copperdogma/TwoSkulls/data/skits.md

# Skull Skits

The source of truth is the Apple Note called "Skull Skits"

One’s always trying to be scary and the other one undercutting him. 

Badger passersby for candy 

Pretend they’re scary/powerful and threaten people

A: The Demon of Parkhill (Anthony)
B: Jeff (Tobias)

## Names

A: did you know we get to choose new names when we die?
B: do we??
A: yes… I was thinking of something grand, like Blade Lord!
B: hmmm… what about… Janice?
A: Janice?! For whom?
B: for youm!
A: what?! I’m a boy!
B: I don’t think so. 
A: what do you mean you don’t think so?! We’re brothers!
B: mmmm… I think not. We don’t really have any boy parts anymore, do we? And if we can choose new names what about Janice and… Angela. 
A: no! From now on you will address me as The Demon of Parkhill!
B: and you may address me as… Jeffia
A: what?! First of all, you’re also a boy. I know this because we’re BROTHERS. Second, what kind of name is Jeffia?!
B: Well… it’s MY name. 
A: I’m calling you Jeff. 

A 0.0
B 3.09
A 4.04
B 10.52
A 16.64
B 19.13
A 20.45
B 22.36
A 23.83
B 26.60
A 38.92
B 45.32
A 49.90
B 58.39
A 1:02.25

## Skin Cream

A: Boo!
B: Ahhh! You scared my skin off!
A: You haven’t had skin in… 200 years!
B: Well maybe I would if you’d got that skin cream I wanted for Christmas. 

## Milkshakes

B: we should go for milkshakes later 
A: what? Where would we put them?
B: In our hands. 
A: What hands?
B: THESE hands
A: We don’t HAVE hands
B: oh yeah. I forgot. …. Can we still get milkshakes, though?

## Fear Exam

A: Begone! There’s nothing but death ahead!
B: And skulls!
A: Yes! And undead fortune-tellers!
B: And kittens!
A: …vicious MAN EATING kittens!
B: with fluffy ears!
A: …dripping with blood!
B: that meow sweetly. 
A: …you didn’t pass your fear exam, did you?
B: I may have cheated off a fluffy unicorn called Sparklepants

## Spears

A: you there! Drop some of that candy at my feet-
B: what feet?
A: …At the bottom of my spear or I’ll-
B: I think it’s just a stick.
A: whatever! It’s a mighty iron rod of-
B: iron?! Did you get iron?? Mine’s wood and the splinters are terrible 
A: it doesn’t matter! Oh, we’re never getting any candy now. No more out of you! This is why I’m the boss!
B: you? Since when were you the boss?
A: Since we were born!
B: …I don’t remember being born. 
…

## Ju Jubes

A: you there! Give me the… (what are the ones I like called?)
B: (ehrm… ju jubes?)
A: YES! JU JUBES! Give me all of your ju jubes!
B: (and smarties)
A: AND SMARTIES! All of your ju jubes and smarties! Or I’ll.. I’ll… (what will I do?)
B: (throw up on you)
A: THROW UP ON—what?!
B: (I don’t know! It was the first thing that came to mind!)
A: (give me another one) If you don’t give me the ju jubes and smarties I’ll-
B: (kick you)
A: -KICK YOU! Wait, what?! We don’t even have any legs! Or feet! Or anything but skulls!
B: I’m having an off night. It’s probably lack of smarties.

## Plastic Monsters

B: it’s so dark out here
A: it’s night time!
B: since when?!
A: since the sun went down!
B: since when did the sun go down?
A: I don’t know! We only get put out every Halloween.
B: Are you sure it’s Halloween today?
A: pretty sure. If not this neighborhood has a terrible tiny plastic monster infestation. 
B: are you talking about us?!
A: no! That!
B: what?
A: THAT!
B: are you pointing?
A: yes?
B: which direction?
A: that direction!
B: ah! Yes I see them now. They’re hideous!

## Pumpkin Flowers

A: what’s your favourite type of flower?
B: the fat orange glowy ones
A: which?
B: like the one across the street. With the face carved into it. 
A: thats a pumpkin!
B: ah yes. Pumpkin flower!
A: pumpkins aren’t flowers!
B: what did you ask me again?
A: what’s your favourite flower?
B the orange glowy ones
A: pumpkins aren’t flowers!
B: how did you know I was talking about pumpkin flowers?
A: pumpkins. aren’t. flowers!
B: what did you ask me again?
A: forget it
B: forget what?

## Favourite Movie

B: hey Anthony 
A: call me THE DEMON OF PARKHILL
B: okay, so Anthony, what’s your favourite movie?
A: <grumble> Frankenstein. I look forward to the day some mad scientist attaches me to a giant, powerful body that will let me crush my enemies!
B: that sounds lovely.
A: Terribly lovely! … what’s yours?
B: I like My Little Pony.
A: I don’t think I’ve seen that. Do the tiny horses tear people apart?
B: no, the ponies go on adventures with rainbows to cotton candy land!
A: I’m not familiar with those terms. Are they methods of torture?
B: no, rainbows are  bright and cheery and cotton candy is lovely and delicious and pink. 
A: …can we watch it later?

## Imitations

A: COWER BEFORE ME, FOR I AM THE DEMON OF PARKHILL!
B: (imitates Anthony) I am the demon of Parkhill!
A: What?! I sound nothing like that! I sound like this!
B: (imitates Anthony) I sound like this!
A: (Imitates Jeff) I s0uNd liKE tHiS! There, that’s you, that’s what you sound like!
B: (imitates Anthony) I am the great and powerful Demon of Parkhill, and I think I’m sooo awesome!
A: … okay.. that one was pretty good.

## Starbucks

A: (Irrationally mad) Jeff… did I see you drinking something earlier?!
B: 	Why, you sure did Anthony, that was our seasonal pumpkin spice latte! We like to embrace the Halloween spirit!
A: …It did smell pretty goo- Wait, what do you mean “we”?!
B: Our weekly special is iced coffee with cream for only 7.99$ at our location in Mission!
A: Why are you talking like that? It’s extremely confusing and… oddly specific.
B: We also sell really bad cake pops!
A: I thought you said NO to the Starbucks sponsorship.
B: Well, a girl’s gotta make a living!
A: …..wait… YOU’RE A GIRL????!!!!

## AI Analysis/Prompt of Jeff and Anthony

## SKIT FORMAT & STRUCTURE

**Length & Pacing:**
- Skits are short, rapid-fire exchanges (typically 10-15 lines of dialogue)
- Quick back-and-forth banter with minimal setup
- Punchline-oriented structure, often ending on a comedic revelation or frustrated outburst

**Dialogue Style:**
- Conversational and naturalistic, with interruptions and tangents
- Frequent use of parenthetical asides (stage whispers, prompting, reactions)
- Lines often trail off with ellipses (...) for comedic timing
- Questions and misunderstandings drive most exchanges

**Comedy Structure:**
- Setup involves A trying to establish something (authority, scariness, a plan)
- B undermines it through literalism, misunderstanding, or cheerful contradiction
- Escalation through repetition or increasing absurdity
- Often ends with A's exasperation or an unexpected twist

---

## CHARACTER PROFILES

**Skull A - "The Demon of Parkhill" (Anthony)**

*Core Personality:*
- Desperately wants to be taken seriously as scary and powerful
- Theatrical and grandiose in speech patterns ("COWER BEFORE ME!")
- Frustrated older-brother energy; constantly trying to maintain control
- Prone to exasperation when undermined (which is constantly)

*Speech Patterns:*
- Uses dramatic, intimidating language ("Begone!", "mighty iron rod")
- Issues commands and threats
- Frequently corrects or scolds B
- Peppers dialogue with dramatic pauses and emphasis
- Gets increasingly flustered when plans fall apart

*Quirks:*
- Insists on his scary title despite no one using it
- Has specific candy preferences (ju jubes and smarties)
- Simultaneously enjoys scary things (Frankenstein) but is open to cute things (willing to watch My Little Pony)
- Gets irrationally upset about small things
- Claims authority as "the boss" despite no evidence

---

**Skull B - Jeff**

*Core Personality:*
- Relentlessly cheerful and literal-minded
- Seems oblivious to social cues and A's frustration
- Embraces whimsy and cuteness without irony
- Forgetful and easily distracted

*Speech Patterns:*
- Simple, straightforward sentences
- Takes everything literally (physical descriptions, metaphors)
- Often asks clarifying questions that derail conversations
- Casual and conversational; rarely intimidating
- Frequently forgets or misunderstands basic information

*Quirks:*
- Fixates on bodily limitations (no hands, no feet, no skin)
- Enjoys traditionally "cute" things (kittens, ponies, sparkles)
- Gender-ambiguous and doesn't care about it
- Makes terrible suggestions when prompted (threatening to throw up, fluffy unicorns)
- Has sponsored content energy (Starbucks bit)
- "Failed" the fear exam by studying with a unicorn named Sparklepants

---

**DYNAMIC BETWEEN THEM:**

The comedy relies on A playing the "straight man" who wants order and scariness, while B is the chaos agent who cheerfully destroys every attempt through innocence rather than malice. A is perpetually losing control while B seems unaware there's even a power struggle happening. Despite A's frustration, there's an underlying sibling affection—they're stuck together and make it work.
