copperdogma/TwoSkulls/docs/research/2026-11-01-jbl-go2.md

# JBL GO 2 connection experiment — 2026-11-01

Historical first experiment. The [follow-up writing utility](2026-11-01-speaker-config-writing.md)
supersedes the temporary-image state below: SD-selected GO 2 was demonstrated
with clear startup speech and Polo, then Jeff was restored to Flip 6 using the
retained utility. The compile-time override is removed.

## Problem and bounded research

Classic Bluetooth discovery, security pairing and A2DP media negotiation are
separate asynchronous stages. An absent first-result name does not prove an
incompatible speaker. Identify the failed stage before changing radio policy.

- [Espressif Classic GAP API](https://docs.espressif.com/projects/esp-idf/en/v5.4/esp32/api-reference/bluetooth/esp_gap_bt.html):
  discovery includes inquiry and name discovery. Missing EIR names may be
  resolved later by the stack. The linked version is 5.4; inspect the installed
  5.5.4 implementation before assuming a version-specific name-resolution fix.
- [Espressif A2DP API, release 5.5](https://docs.espressif.com/projects/esp-idf/en/release-v5.5/esp32/api-reference/bluetooth/esp_a2dp.html):
  connect to the sink address after source initialization and inspect asynchronous
  connection/media results.
- [JBL GO 2 manual](https://jp.jbl.com/on/demandware.static/-/Sites-masterCatalog_Harman/default/dw5193d0bc/pdfs/JBL_GO2_Instruction-Manual_JAPANESE.pdf):
  Bluetooth button enters pairing mode; legacy PIN is 0000 if requested.
- [JBL GO 2 specifications](https://www.jbl.com/on/demandware.static/-/Sites-masterCatalog_Harman/default/dw26d91c33/pdfs/JBL_GO2_Spec_Sheet_English.pdf):
  A2DP sink support makes a Classic ESP32 source a plausible compatible source.
  Specifications alone do not demonstrate this unit working.

Decision: first select the requested speaker, retain exact-name selection and
existing PIN/SSP behavior, then observe discovery, authentication, negotiated
codec and PCM. Do not add retries or codec workarounds without evidence.

Installed 5.5.4 `esp_gap_bt_api.h` lines 636–640 explicitly confirms discovery
produces `ESP_BT_GAP_DISC_RES_EVT` for both inquiry and subsequent name discovery.
Current code consumes those results and waits for discovery stop; no extra
remote-name operation is justified before a local discovery failure is observed.

## Experiment setup

Active source is `codex/jaw-articulation` at 757d5ac, not historical Arduino main.
Connected board verified as Jeff, base MAC f4:2d:c9:78:ad:78. Initial serial
shows ESP-IDF 5.5.4, ELF prefix 6cd2543e7, role secondary, SD mounted and configured
speaker JBL Flip 6, volume 60%. Status/fault-log collected before changes; no
pending report. Opening serial incidentally reset the USB board despite reset
being disabled in the helper, as already documented for this USB driver.

The saved rollback application was verified against actual flash at 0x30000
(esptool digest matched). Private evidence/rollback ELF and BIN:
`build/validation/jbl-go2-20261101/`; initial capture:
`build/validation/2026-11-01-jbl-go2-initial.log`.

Test build option `SKULL_JBL_GO2_EXPERIMENT=ON` overrides only secondary radio
selection to `JBL GO 2`. Default OFF retains SD selection. It does not rewrite SD
config or erase bonds/NVS. Reflash the verified rollback image to restore normal
selection. Ordinary successful pairing may write Bluetooth bonds and the
name-bound speaker cache; preserve unrelated NVS namespaces.

Cam confirmed GO 2 discoverable on the phone after forgetting its old pairing.
Connection and acoustic results follow below; power-cycle recovery remains open.

Build with the experimental option passed. Application-only write at 0x30000
completed with esptool hash verification; running ELF prefix a96f48a40. Rollback
BIN SHA256 b2aaa5163be6811b437e270bdb70afc5e03a5b0d125a770ff9b538201e65d013;
experiment BIN SHA256 b6cd4c07ae0a1dd22eeff6b4225c136fbd57678de15d59478680a13f95ccc36e.
`live.log` confirms the override, healthy mounted card and inquiry start/stop,
but the first completed inquiry received no candidates. Requested the physical
Bluetooth button again because discovery may have expired during the build;
this is not yet evidence of an authentication or A2DP failure.

## Live result

After Cam renewed pairing mode, inquiry saw an unnamed result and then the exact
`JBL GO 2` name at the same address (2c:fd:b4:eb:84:a7). This locally demonstrates
the existing two-stage name discovery works; no name-resolution workaround needed.
At uptime 128.050 s the exact candidate was selected; authentication status 0
at 130.800 s, A2DP connected at 130.870 s, media start success at 130.950 s.
SBC raw 21:15:02:35, 44.1 kHz stereo, bitpool 2..53. Startup PCM completed at
134.900 s. Status at 136.290 s: speaker=1, stream=1, dropped=0, fault=0.

No radio/security/codec change was required for this first successful software
connection. The physical pairing window and selecting GO 2 rather than Flip 6
were sufficient in this experiment. The historical Arduino failure was not
reproduced or diagnosed. Acoustic confirmation and power-cycle recovery remain
separate from the successful connection/PCM-delivery telemetry.

At the end of the first experiment Jeff ran the explicit test image selecting
GO 2; SD config still selected Flip 6. No Anthony or Death image was changed.
Changes were local/uncommitted at that stage. Saved artifacts make the original
experiment and return to the verified previous application reviewable.

## Acoustic confirmation

Cam reported no audible initial startup announcement despite completed source
PCM. Keep that negative observation: cold-start speech readiness is unresolved.
Do not call the initial startup acoustically successful or assume a cause.

Explicit serial `tone` was accepted at 156.010 s and Cam heard it. Next,
`play /audio/Polo.wav` was accepted at 165.310 s, played at 165.440 s and
completed at 166.000 s: 24,289 frames, zero underruns. Cam reported “I heard
Polo” and confirmed clear speech through GO 2. Status after playback:
speaker=1, stream=1, dropped=0, fault=0, SD mounted, actuator stuck=0.
This establishes an audible live connection and SD speech playback; sustained
show playback, power-cycle reconnection and first-announcement timing remain
unqualified. Leave the selected experimental image running for Cam's experiment.
