copperdogma/TwoSkulls/hardware/perfboard/draft-v4/perfboarder-draft.png

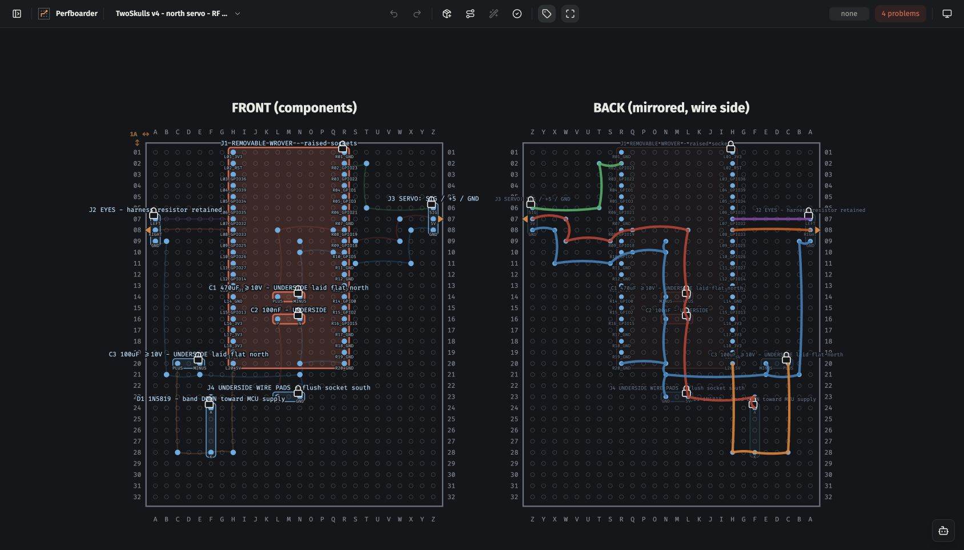
hardware/perfboard/draft-v4/perfboarder-draft.png
