copperdogma/TwoSkulls/hardware/perfboard/tool-trial/perfboarder-trial.png

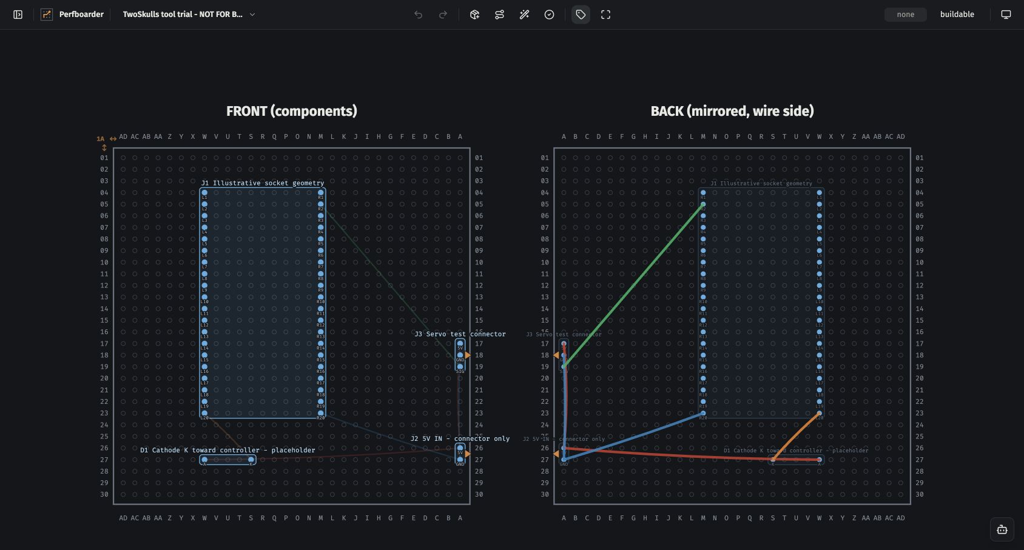
hardware/perfboard/tool-trial/perfboarder-trial.png
