copperdogma/TwoSkulls/hardware/perfboard/draft-v4/wiring.csv

net | from | from_col_row | to | to_col_row
EXT_5V | @12,8 | (12, 8) | C1.PLUS | (12, 14)
EXT_5V | C1.PLUS | (12, 14) | C2.P | (12, 16)
EXT_5V | C2.P | (12, 16) | J4.5V | (12, 23)
EXT_5V | @12,8 | (12, 8) | @17,8 | (17, 8)
EXT_5V | @17,8 | (17, 8) | @19,9 | (19, 9)
EXT_5V | @19,9 | (19, 9) | @23,9 | (23, 9)
EXT_5V | @23,9 | (23, 9) | @23,7 | (23, 7)
EXT_5V | @23,7 | (23, 7) | J3.5V | (26, 7)
EXT_5V | J4.5V | (12, 23) | @6,23 | (6, 23)
EXT_5V | @6,23 | (6, 23) | D1.A | (6, 24)
GND | @14,9 | (14, 9) | @14,10 | (14, 10)
GND | @14,10 | (14, 10) | C1.MINUS | (14, 14)
GND | C1.MINUS | (14, 14) | C2.N | (14, 16)
GND | C2.N | (14, 16) | @14,20 | (14, 20)
GND | @14,20 | (14, 20) | @14,21 | (14, 21)
GND | @14,21 | (14, 21) | J4.GND | (14, 23)
GND | @14,10 | (14, 10) | @17,10 | (17, 10)
GND | @17,10 | (17, 10) | @19,11 | (19, 11)
GND | @19,11 | (19, 11) | @24,11 | (24, 11)
GND | @24,11 | (24, 11) | @24,8 | (24, 8)
GND | @24,8 | (24, 8) | J3.GND | (26, 8)
GND | @14,20 | (14, 20) | J1.R20_GND | (18, 20)
GND | @14,21 | (14, 21) | @5,21 | (5, 21)
GND | @5,21 | (5, 21) | @2,21 | (2, 21)
GND | @2,21 | (2, 21) | @2,9 | (2, 9)
GND | @2,9 | (2, 9) | J2.GND | (1, 9)
GND | @5,21 | (5, 21) | C3.MINUS | (5, 20)
MCU_5V | D1.K | (6, 28) | @8,28 | (8, 28)
MCU_5V | @8,28 | (8, 28) | J1.L20_5V | (8, 20)
MCU_5V | D1.K | (6, 28) | @3,28 | (3, 28)
MCU_5V | @3,28 | (3, 28) | C3.PLUS | (3, 20)
EYE_LEFT | J1.L07_GPIO32 | (8, 7) | J2.LEFT | (1, 7)
EYE_RIGHT | J1.L08_GPIO33 | (8, 8) | J2.RIGHT | (1, 8)
SERVO_PWM | J1.R02_GPIO23 | (18, 2) | @20,2 | (20, 2)
SERVO_PWM | @20,2 | (20, 2) | @20,6 | (20, 6)
SERVO_PWM | @20,6 | (20, 6) | J3.SIG | (26, 6)
