copperdogma/TwoSkulls/hardware/perfboard/draft-v1/wiring.csv

net | endpoint_a | hole_a_col_row | endpoint_b | hole_b_col_row
EXT_5V | J4.5V | (20, 23) | @20,20 | (20, 20)
EXT_5V | @20,20 | (20, 20) | @21,20 | (21, 20)
EXT_5V | @21,20 | (21, 20) | @21,19 | (21, 19)
EXT_5V | @21,19 | (21, 19) | @21,13 | (21, 13)
EXT_5V | @21,13 | (21, 13) | @21,9 | (21, 9)
EXT_5V | @21,9 | (21, 9) | C2.P | (23, 9)
EXT_5V | @21,13 | (21, 13) | J3.5V | (26, 13)
EXT_5V | @21,19 | (21, 19) | C1.PLUS | (23, 19)
EXT_5V | J4.5V | (20, 23) | @18,23 | (18, 23)
EXT_5V | @18,23 | (18, 23) | @18,26 | (18, 26)
EXT_5V | @18,26 | (18, 26) | @5,26 | (5, 26)
EXT_5V | @5,26 | (5, 26) | D1.A | (5, 25)
MCU_5V | D1.K | (5, 21) | @2,21 | (2, 21)
MCU_5V | @2,21 | (2, 21) | C3.PLUS | (2, 28)
MCU_5V | D1.K | (5, 21) | @8,21 | (8, 21)
MCU_5V | @8,21 | (8, 21) | J1.L20_5V | (8, 20)
GND | J4.GND | (20, 24) | @21,24 | (21, 24)
GND | @21,24 | (21, 24) | @21,21 | (21, 21)
GND | @21,21 | (21, 21) | @25,21 | (25, 21)
GND | @25,21 | (25, 21) | C1.MINUS | (25, 19)
GND | C1.MINUS | (25, 19) | @25,14 | (25, 14)
GND | @25,14 | (25, 14) | C2.N | (25, 9)
GND | @25,14 | (25, 14) | J3.GND | (26, 14)
GND | @19,24 | (19, 24) | @19,29 | (19, 29)
GND | @19,29 | (19, 29) | @4,29 | (4, 29)
GND | @4,29 | (4, 29) | C3.MINUS | (4, 28)
GND | J4.GND | (20, 24) | @19,24 | (19, 24)
GND | @19,24 | (19, 24) | @19,21 | (19, 21)
GND | @19,21 | (19, 21) | @19,20 | (19, 20)
GND | @19,20 | (19, 20) | J1.R20_GND | (18, 20)
GND | @4,29 | (4, 29) | @4,10 | (4, 10)
GND | @4,10 | (4, 10) | @1,10 | (1, 10)
GND | @1,10 | (1, 10) | J2.GND | (1, 9)
EYE_LEFT | J1.L07_GPIO32 | (8, 7) | J2.LEFT | (1, 7)
EYE_RIGHT | J1.L08_GPIO33 | (8, 8) | J2.RIGHT | (1, 8)
SERVO_PWM | J1.R02_GPIO23 | (18, 2) | @20,2 | (20, 2)
SERVO_PWM | @20,2 | (20, 2) | @20,12 | (20, 12)
SERVO_PWM | @20,12 | (20, 12) | J3.SIG | (26, 12)
