copperdogma/TwoSkulls/hardware/perfboard/draft-v2/wiring.csv

net | from | from_col_row | to | to_col_row
EXT_5V | @9,6 | (9, 6) | @9,22 | (9, 22)
EXT_5V | @9,22 | (9, 22) | @9,24 | (9, 24)
EXT_5V | @9,24 | (9, 24) | C2.P | (9, 25)
EXT_5V | C2.P | (9, 25) | C1.PLUS | (9, 28)
EXT_5V | @9,22 | (9, 22) | D1.A | (6, 22)
EXT_5V | @9,24 | (9, 24) | @18,24 | (18, 24)
EXT_5V | @18,24 | (18, 24) | J3.5V | (26, 24)
EXT_5V | @18,24 | (18, 24) | @18,28 | (18, 28)
EXT_5V | @18,28 | (18, 28) | J4.5V | (20, 28)
GND | @11,6 | (11, 6) | @11,20 | (11, 20)
GND | @11,20 | (11, 20) | @11,21 | (11, 21)
GND | @11,21 | (11, 21) | C2.N | (11, 25)
GND | C2.N | (11, 25) | C1.MINUS | (11, 28)
GND | C1.MINUS | (11, 28) | @11,30 | (11, 30)
GND | @11,20 | (11, 20) | J1.R20_GND | (18, 20)
GND | @11,21 | (11, 21) | @4,21 | (4, 21)
GND | @4,21 | (4, 21) | @3,21 | (3, 21)
GND | @3,21 | (3, 21) | @3,9 | (3, 9)
GND | @3,9 | (3, 9) | J2.GND | (1, 9)
GND | C2.N | (11, 25) | J3.GND | (26, 25)
GND | @4,21 | (4, 21) | C3.MINUS | (4, 23)
GND | @11,30 | (11, 30) | @20,30 | (20, 30)
GND | @20,30 | (20, 30) | J4.GND | (20, 29)
MCU_5V | D1.K | (6, 26) | @8,26 | (8, 26)
MCU_5V | @8,26 | (8, 26) | J1.L20_5V | (8, 20)
MCU_5V | D1.K | (6, 26) | @2,26 | (2, 26)
MCU_5V | @2,26 | (2, 26) | C3.PLUS | (2, 23)
EYE_LEFT | J1.L07_GPIO32 | (8, 7) | J2.LEFT | (1, 7)
EYE_RIGHT | J1.L08_GPIO33 | (8, 8) | J2.RIGHT | (1, 8)
SERVO_PWM | J1.R02_GPIO23 | (18, 2) | @20,2 | (20, 2)
SERVO_PWM | @20,2 | (20, 2) | @20,23 | (20, 23)
SERVO_PWM | @20,23 | (20, 23) | J3.SIG | (26, 23)
