copperdogma/TwoSkulls/hardware/perfboard/draft-v4/assembly-plan.png

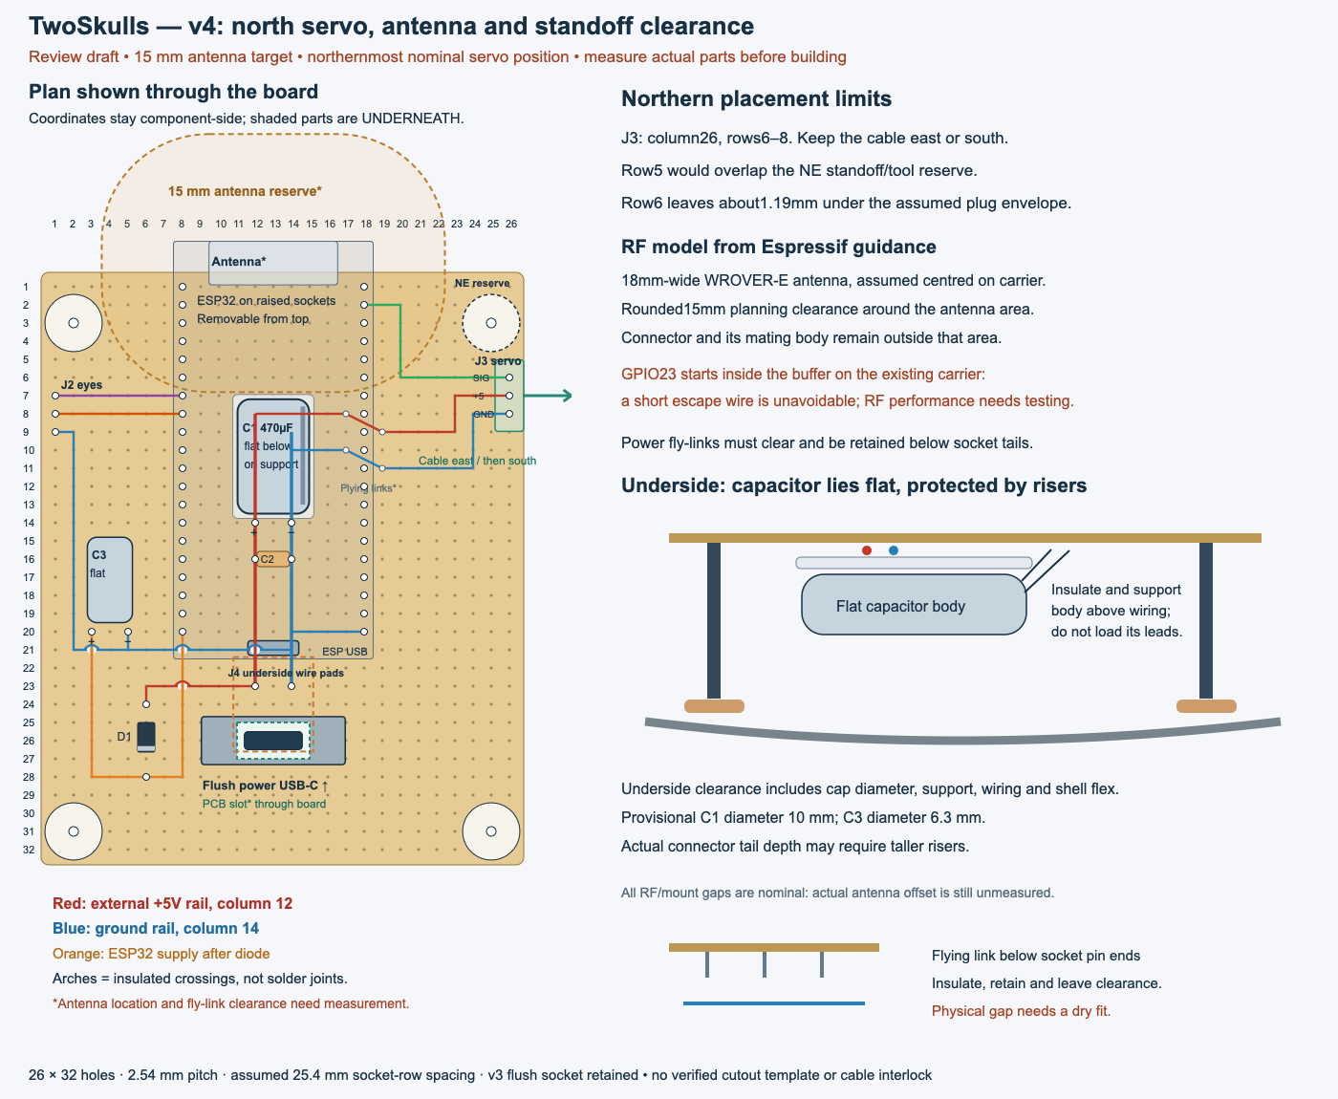
hardware/perfboard/draft-v4/assembly-plan.png
