copperdogma/TwoSkulls/docs/validation/2026-10-15-checkin.md

# Shared WROVER firmware check-in — 2026-10-15

Scope: onboard-SD migration baseline, native ESP-IDF dual-role application,
research/implementation evidence, host tests and a repeatable host-test runner.
All work is isolated on `codex/onboard-sd-migration`; the original checkout stays
unchanged. Next work is the physical board design, rather than another software
architecture migration.

## Validation

- `python3 scripts/run_host_tests.py`: passed. Eight Python tests and eight C++
  production-source suites under Address/UndefinedBehaviorSanitizer, including
  all15 real WAV fixtures, catalog/config/storage, primary/secondary control,
  actual PCM producer, actuator timing and28 deterministic show scenarios.
- ESP-IDF5.5.4 native build: passed. Rebuilt image SHA256 matches the exact image
  hash-verified on both connected boards:
  `cf4692a71f1f29405cf85f77b9c03606e826ea2730444cd1c633aec85cc88a25`.
- Strict offline asset preflight: one existing authored-data failure remains,
  `Skit - names.wav: line 15: interval extends beyond PCM data`. Verified no other
  errors. Runtime clips the final interval at EOF and accepts all15assets;
  authored repository/card content remains untouched. This is not an all-assets
  authoring-clean claim.
- Hardware: both boards completed Starbucks1647341frames and Home-triggered
  imitations1341581frames with zero reported underruns. Cam confirmed clean
  alternating dialogue and Home switch reset to off. Startup margin correction
  and Jeff's initialization/Polo were owner-confirmed. See
  [the two-board record](2026-10-15-jeff-first-boot.md).
- Independent source/concurrency and commit-candidate review: no blocking finding.
  No firmware binaries, device backups, generated SDK/build files, private serial
  captures or commissioning credentials are included. Dependency lockfile is
  intentionally tracked. `git diff --check` passed.

## Remaining physical/resource acceptance

Jeff's disconnected jaw/eyes, precise acoustic offset, fault-injection/recovery,
full-load memory margin and yard/long-soak checks remain open. Static IRAM margin
is993bytes; primary local-window low31191bytes is below the proposed32KiB floor.
Do not turn these bounded bench results into a full hardware/soak qualification.
The original images remain private outside Git. Ordinary future app updates
must preserve each board's native NVS and SD contents.

Ignored validation outputs use the `2026-10-15-checkin-*` prefix. The checked-in
runner uses isolated temporary fixtures and does not access connected hardware.
