copperdogma/TwoSkulls/firmware/main/app_main.cpp

#include <algorithm>
#include <atomic>
#include <cstdio>
#include <cstring>
#include <new>
#include "freertos/FreeRTOS.h"
#include "freertos/task.h"
#include "driver/uart.h"
#include "esp_heap_caps.h"
#include "esp_log.h"
#include "esp_psram.h"
#include "esp_system.h"
#include "esp_timer.h"
#include "esp_wifi.h"
#include "nvs_flash.h"
#include <esp_matter.h>
#include <app/server/Server.h>
#include <platform/CHIPDeviceLayer.h>
#include <setup_payload/OnboardingCodesUtil.h>
#include "skull_radio.h"
#include "skull_storage.h"
#include "skull_startup.h"
#include "skull_actuators.h"
#include "skull_audio.h"
#include "skull_catalog.h"
#include "skull_show.h"
#include "skull_fault_log.h"
#include "skull_secondary.h"
#include "skull_network.h"

using namespace esp_matter;
using namespace chip::app::Clusters;
namespace {
const char *tag = "skull"; // Set once from validated SD config before starting tasks.
std::atomic<uint32_t> tone_frames{0};
std::atomic<uint32_t> callback_max_us{0};
std::atomic<uint32_t> triggers{0};
std::atomic<bool> matter_ble_ready{false};
uint16_t trigger_endpoint = 0;
bool internal_update = false; // Accessed only on Matter's system layer.
skull::storage::Config card_config;
skull::catalog::Catalog *assets = nullptr;
bool heap_window = false; // Diagnostic task only.
int64_t app_entry_us = 0;

// Existing control task owns these snapshots. Polling does not start Wi-Fi on
// the secondary role and never logs SSIDs, addresses or provisioning material.
void lifecycle_poll() {
    static bool startup_recorded = false, local_ready_recorded = false, ready_recorded = false;
    static bool peer_seen = false, peer_was_ready = false;
    static int64_t next_wifi = 0;
    const int64_t time = esp_timer_get_time();
    if (!startup_recorded && skull::startup::finished()) {
        startup_recorded = true;
        ESP_LOGI("lifecycle", "event=startup_finished boot_ms=%lld app_ms=%lld terminal=1",
                 static_cast<long long>(time / 1000), static_cast<long long>((time - app_entry_us) / 1000));
    }
    if (!local_ready_recorded && assets && skull::startup::finished() && skull::radio::stream_ready()) {
        local_ready_recorded = true;
        ESP_LOGI("lifecycle", "event=local_ready boot_ms=%lld app_ms=%lld scope=local_audio peer=%d",
                 static_cast<long long>(time / 1000), static_cast<long long>((time - app_entry_us) / 1000),
                 card_config.primary ? skull::radio::peer_ready() : skull::secondary::connected());
    }
    const bool ready = card_config.primary ? skull::show::ready() :
        assets && skull::startup::finished() && skull::radio::stream_ready() &&
        !skull::show::busy() && !skull::audio::busy();
    if (!ready_recorded && ready) {
        ready_recorded = true;
        ESP_LOGI("lifecycle", "event=ready boot_ms=%lld app_ms=%lld scope=%s",
                 static_cast<long long>(time / 1000), static_cast<long long>((time - app_entry_us) / 1000),
                 card_config.primary ? "paired_trigger" : "secondary_local_audio");
    }
    const bool peer = card_config.primary ? skull::radio::peer_ready() : skull::secondary::connected();
    if (!peer_seen || peer != peer_was_ready) {
        peer_seen = true; peer_was_ready = peer;
        ESP_LOGI("lifecycle", "event=peer_ready boot_ms=%lld ready=%d role=%s scope=%s service_ready=%d",
                 static_cast<long long>(time / 1000), peer, card_config.primary ? "primary" : "secondary",
                 card_config.primary ? "client_ready" : "link_connected", skull::secondary::ready());
    }
    if (time < next_wifi) return;
    const bool first_wifi = next_wifi == 0;
    next_wifi = time + 30000000;
    if (!card_config.primary && !skull::network::wifi_started()) {
        // Jeff can now use optional SD-provided Wi-Fi without starting Matter.
        if (first_wifi)
            ESP_LOGI("lifecycle", "event=wifi_sample boot_ms=%lld state=disabled_role", static_cast<long long>(time / 1000));
        return;
    }
    wifi_ap_record_t ap{};
    const esp_err_t wifi = esp_wifi_sta_get_ap_info(&ap);
    if (wifi == ESP_OK)
        ESP_LOGI("lifecycle", "event=wifi_sample boot_ms=%lld state=connected rssi_dbm=%d channel=%u",
                 static_cast<long long>(time / 1000), ap.rssi, static_cast<unsigned>(ap.primary));
    else
        ESP_LOGI("lifecycle", "event=wifi_sample boot_ms=%lld state=unavailable result=%s",
                 static_cast<long long>(time / 1000), esp_err_to_name(wifi));
}

esp_err_t boot_storage_attempt(unsigned attempt) {
    const int64_t started = esp_timer_get_time();
    ESP_LOGI("lifecycle", "event=sd_attempt boot_ms=%lld attempt=%u", static_cast<long long>(started / 1000), attempt);
    const esp_err_t result = skull::storage::mount_and_read_config(card_config);
    const int64_t ended = esp_timer_get_time();
    ESP_LOGI("lifecycle", "event=sd_result boot_ms=%lld attempt=%u duration_ms=%lld scope=mount_and_config mounted=%d result=%s",
             static_cast<long long>(ended / 1000), attempt, static_cast<long long>((ended - started) / 1000),
             skull::storage::mounted(), esp_err_to_name(result));
    return result;
}

// Startup PCM has priority over the explicit diagnostic tone.
// No card I/O, logging, allocation or blocking in this provider.
int32_t provide_pcm(uint8_t *data, int32_t length) {
    if (!data || length <= 0) return 0;
    const int64_t started = esp_timer_get_time();
    std::memset(data, 0, static_cast<size_t>(length));
    const bool startup = skull::startup::provide(data, length);
    const bool show_audio = !startup && skull::audio::provide(data, length);
    const uint32_t remaining = tone_frames.load(std::memory_order_relaxed);
    const uint32_t count = startup || show_audio ? 0 : std::min(static_cast<uint32_t>(length / 4), remaining);
    static uint32_t phase = 0;
    for (uint32_t index = 0; index < count; ++index) {
        const int16_t sample = static_cast<int16_t>((phase < 50 ? static_cast<int>(phase) - 25 : 75 - static_cast<int>(phase)) * 20);
        std::memcpy(data + index * 4, &sample, 2);
        std::memcpy(data + index * 4 + 2, &sample, 2);
        phase = (phase + 1) % 100;
    }
    // Only the provider decrements. Trigger requests are accepted only at zero.
    if (count) tone_frames.fetch_sub(count, std::memory_order_relaxed);
    const uint32_t elapsed = static_cast<uint32_t>(esp_timer_get_time() - started);
    uint32_t maximum = callback_max_us.load(std::memory_order_relaxed);
    while (elapsed > maximum && !callback_max_us.compare_exchange_weak(maximum, elapsed, std::memory_order_relaxed)) {}
    return length;
}

bool request_tone() {
    if (skull::actuators::jaw_state().mode != skull::actuators::JawMode::automatic ||
        !skull::radio::stream_ready() || skull::startup::busy() || skull::audio::busy() || skull::show::busy()) return false;
    uint32_t expected = 0;
    if (!tone_frames.compare_exchange_strong(expected, 13230)) return false;
    triggers.fetch_add(1, std::memory_order_relaxed);
    return true;
}

void reset_momentary(chip::System::Layer *, void *) {
    internal_update = true;
    auto off = esp_matter_bool(false);
    const esp_err_t result = attribute::update(trigger_endpoint, OnOff::Id, OnOff::Attributes::OnOff::Id, &off);
    internal_update = false;
    if (result != ESP_OK && result != ESP_ERR_NOT_FINISHED)
        ESP_LOGW(tag, "Momentary Off reset: %s", esp_err_to_name(result));
}

esp_err_t attribute_update(attribute::callback_type_t type, uint16_t endpoint, uint32_t cluster,
                           uint32_t attribute_id, esp_matter_attr_val_t *value, void *) {
    if (type != attribute::PRE_UPDATE || internal_update || endpoint != trigger_endpoint ||
        cluster != OnOff::Id || attribute_id != OnOff::Attributes::OnOff::Id ||
        value->type != ESP_MATTER_VAL_TYPE_BOOLEAN || !value->val.b) return ESP_OK;
    const bool accepted = skull::show::trigger();
    if (accepted) triggers.fetch_add(1, std::memory_order_relaxed);
    ESP_LOGI(tag, "Matter skit trigger %s", accepted ? "accepted" : "ignored (startup/busy/cooldown/speaker unavailable)");
    chip::DeviceLayer::SystemLayer().StartTimer(chip::System::Clock::Milliseconds32(300), reset_momentary, nullptr);
    return ESP_OK;
}

esp_err_t identify(identification::callback_type_t, uint16_t, uint8_t, uint8_t, void *) { return ESP_OK; }

void matter_event(const chip::DeviceLayer::ChipDeviceEvent *event, intptr_t) {
    // GAP callback registration is earlier than advertising/address setup.
    // Don't start our scanner until uncommissioned Matter has finished it.
    if (event->Type == chip::DeviceLayer::DeviceEventType::kCHIPoBLEAdvertisingChange &&
        event->CHIPoBLEAdvertisingChange.Result == chip::DeviceLayer::kActivity_Started)
        matter_ble_ready.store(true);
    if (event->Type == chip::DeviceLayer::DeviceEventType::kCommissioningComplete)
        ESP_LOGI(tag, "Matter commissioning complete");
    else if (event->Type == chip::DeviceLayer::DeviceEventType::kBLEDeinitialized)
        ESP_LOGE(tag, "Unexpected Matter BLE deinitialization: retained Bluetooth gate FAILED");
    else if (event->Type == chip::DeviceLayer::DeviceEventType::kFabricRemoved)
        ESP_LOGI(tag, "Matter fabric removed; use explicit commissioning-window command to re-add");
}

bool fault_log_idle() {
    // Waiting startup PCM is immutable in PSRAM; this owner is the only task
    // that can start it. It cannot start playback until synchronous I/O returns.
    return !skull::show::busy() && skull::audio::quiescent() &&
           !skull::startup::playing() && tone_frames.load() == 0;
}

void status() {
    skull::network::status();
    skull::faultlog::status();
    const auto radio = skull::radio::stats();
    const auto audio = skull::audio::stats();
    const auto actuators = skull::actuators::stats();
    const auto jaw = skull::actuators::jaw_state();
    ESP_LOGI(tag, "JAW mode=%u requested_us=%u applied_us=%u enabled=%d closed_us=%u open_us=%u manual_bounds=%u..%u faulted=%d (command state, not position feedback)",
             static_cast<unsigned>(jaw.mode), jaw.requested_us, jaw.applied_us, jaw.enabled,
             jaw.closed_us, jaw.open_us, jaw.minimum_us, jaw.maximum_us, jaw.faulted);
    ESP_LOGI(tag, "ACTUATORS deferred=%lu max_pending_us=%llu pending_channels=%u stuck=%d",
             static_cast<unsigned long>(actuators.deferred_updates),
             static_cast<unsigned long long>(actuators.max_pending_us),
             static_cast<unsigned>(actuators.pending_channels), actuators.stuck);
    ESP_LOGI(tag, "PRODUCER blocks=%lu read_total_us=%lu read_max_us=%lu process_total_us=%lu process_max_us=%lu refill_gap_max_us=%lu role_frames=%lu raw_nonzero=%lu output_nonzero=%lu peak=%lu",
             static_cast<unsigned long>(audio.blocks), static_cast<unsigned long>(audio.read_us_total),
             static_cast<unsigned long>(audio.read_us_max), static_cast<unsigned long>(audio.process_us_total),
             static_cast<unsigned long>(audio.process_us_max), static_cast<unsigned long>(audio.refill_gap_us_max),
             static_cast<unsigned long>(audio.role_frames), static_cast<unsigned long>(audio.input_nonzero_samples),
             static_cast<unsigned long>(audio.output_nonzero_samples), static_cast<unsigned long>(audio.output_peak));
    ESP_LOGI(tag, "SHOW state=%s PCM frames=%lu underruns=%lu producer_stack=%lu cancel_waiting=%d assets=%u heap_window=%d secondary_ready=%d",
             skull::show::state_name(), static_cast<unsigned long>(audio.frames),
             static_cast<unsigned long>(audio.underruns), static_cast<unsigned long>(audio.stack_high_water),
             audio.cancel_waiting, assets ? static_cast<unsigned>(assets->count) : 0,
             heap_window, skull::secondary::ready());
    ESP_LOGI(tag, "STATUS sd=%d speaker=%d peer=%d tone_frames=%lu triggers=%lu callbacks=%lu bytes=%lu cb_max_us=%lu dropped=%lu internal=%u min_internal=%u largest=%u psram=%u stream=%d fault=%d",
             skull::storage::mounted(), skull::radio::speaker_connected(), skull::radio::peer_ready(),
             static_cast<unsigned long>(tone_frames.load()), static_cast<unsigned long>(triggers.load()),
             static_cast<unsigned long>(radio.audio_callbacks), static_cast<unsigned long>(radio.audio_bytes),
             static_cast<unsigned long>(callback_max_us.load()), static_cast<unsigned long>(radio.dropped_events),
             static_cast<unsigned>(heap_caps_get_free_size(MALLOC_CAP_INTERNAL | MALLOC_CAP_8BIT)),
             static_cast<unsigned>(heap_caps_get_minimum_free_size(MALLOC_CAP_INTERNAL | MALLOC_CAP_8BIT)),
             static_cast<unsigned>(heap_caps_get_largest_free_block(MALLOC_CAP_INTERNAL | MALLOC_CAP_8BIT)),
             static_cast<unsigned>(heap_caps_get_free_size(MALLOC_CAP_SPIRAM)), skull::radio::stream_ready(), radio.faulted);
    ESP_LOGI(tag, "STACK minimum unused bytes: radio=%lu diagnostic=%u; DMA free=%u",
             static_cast<unsigned long>(radio.stack_free_min),
             static_cast<unsigned>(uxTaskGetStackHighWaterMark(nullptr)),
             static_cast<unsigned>(heap_caps_get_free_size(MALLOC_CAP_DMA | MALLOC_CAP_INTERNAL)));
}

// Boot recovery has no audio worker/radio/show yet. Keep its command surface
// read-only except for requesting another ordinary mount attempt.
void wait_for_boot_storage_retry(esp_err_t error, unsigned attempt) {
    const bool card_mounted = skull::storage::mounted();
    const unsigned blinks = card_mounted ? 5 : 3;
    const char *problem = !card_mounted ? "SD initialization/filesystem mount unavailable" :
                          error == ESP_ERR_NOT_FOUND ? "SD mounted but config.txt missing" :
                          error == ESP_ERR_INVALID_ARG ? "SD mounted but config.txt invalid" :
                          "SD mounted but config.txt unavailable";
    // One quick retry, then 30-second automatic intervals. Repeated failures
    // remain observable instead of continuously churning card initialization.
    const uint32_t wait_ms = attempt == 1 ? skull::actuators::diagnostic_duration_ms(blinks) : 30000;
    const int64_t retry_at = esp_timer_get_time() + static_cast<int64_t>(wait_ms) * 1000;
    ESP_LOGW(tag, "BOOT attempt=%u: %s (%s); %u eye flashes, next retry in %lu ms",
             attempt, problem, esp_err_to_name(error), blinks, static_cast<unsigned long>(wait_ms));
    if (attempt >= 2 && !card_mounted && error == ESP_ERR_TIMEOUT)
        ESP_LOGW(tag, "Repeated SD startup timeout: standard reinitialization has not recovered access; card power recovery may be needed. Capture status/fault-log first");
    ESP_LOGI(tag, "BOOT commands: status, fault-log, sd-retry. Config writes, playback and reset commands unavailable until valid card config loads");
    skull::actuators::diagnostic(blinks, true);
    // Preserve parser state across retry boundaries so a long command cannot
    // become an executable suffix when an automatic mount attempt intervenes.
    static char line[64]{};
    static size_t used = 0;
    static bool overflowed = false;
    while (esp_timer_get_time() < retry_at) {
        skull::actuators::tick(0, false);
        // No SD writes in this path, even if FAT mounted but config is invalid.
        skull::faultlog::poll(true, false);
        char character;
        if (uart_read_bytes(UART_NUM_0, &character, 1, pdMS_TO_TICKS(20)) != 1) continue;
        if (character == '\r' || character == '\n') {
            if (overflowed) ESP_LOGW(tag, "BOOT command discarded: overlong or invalid line");
            else if (used) {
                line[used] = 0;
                if (!std::strcmp(line, "status")) {
                    const int64_t remaining_ms = std::max<int64_t>(0, (retry_at - esp_timer_get_time()) / 1000);
                    ESP_LOGI(tag, "BOOT attempt=%u valid_config=0 mounted=%d last_error=%s retry_in_ms=%llu state='%s'",
                             attempt, card_mounted, esp_err_to_name(error),
                             static_cast<unsigned long long>(remaining_ms), problem);
                    status(); // All snapshots are safe before worker initialization.
                } else if (!std::strcmp(line, "fault-log")) skull::faultlog::dump();
                else if (!std::strcmp(line, "sd-retry")) {
                    ESP_LOGI(tag, "BOOT manual SD retry requested");
                    used = 0;
                    overflowed = false;
                    return;
                } else ESP_LOGW(tag, "BOOT command unavailable; use status, fault-log or sd-retry");
            }
            used = 0;
            overflowed = false;
        } else if (!overflowed) {
            const auto value = static_cast<unsigned char>(character);
            if (value < 32 || value == 127) { used = 0; overflowed = true; }
            else if (used < sizeof(line) - 1) line[used++] = character;
            else { used = 0; overflowed = true; } // Discard the entire line, never execute a suffix.
        }
    }
}

void inspect_asset(const char *path) {
    if (!assets) return;
    for (size_t i = 0; i < assets->count; ++i) {
        const auto &asset = assets->assets[i];
        if (std::strcmp(path, asset.path)) continue;
        ESP_LOGI(tag, "ASSET role=%c path=%s frames=%lu lines=%u skit=%d",
                 card_config.primary ? 'A' : 'B', asset.path,
                 static_cast<unsigned long>(asset.wave.data_bytes / 4),
                 static_cast<unsigned>(asset.line_count), asset.skit);
        for (unsigned line = 0; line < asset.line_count; ++line) {
            const auto &interval = asset.lines[line];
            ESP_LOGI(tag, "ASSET interval=%u role=%c frames=%lu..%lu", line, interval.role,
                     static_cast<unsigned long>(interval.first_frame),
                     static_cast<unsigned long>(interval.end_frame));
        }
        return;
    }
    ESP_LOGW(tag, "ASSET not found: %s", path);
}

void pairing() {
    // Called only on Matter's system layer. Do not open an additional fabric
    // window on a commissioned device through this diagnostic command.
    if (chip::Server::GetInstance().GetFabricTable().FabricCount() != 0) {
        ESP_LOGI(tag, "Already commissioned; use Home's existing accessory");
        return;
    }
    auto &manager = chip::Server::GetInstance().GetCommissioningWindowManager();
    if (!manager.IsCommissioningWindowOpen()) {
        const CHIP_ERROR error = manager.OpenBasicCommissioningWindow(chip::System::Clock::Seconds32(300));
        if (error != CHIP_NO_ERROR) {
            ESP_LOGE(tag, "Commissioning window failed: %" CHIP_ERROR_FORMAT, error.Format());
            return;
        }
    }
    PrintOnboardingCodes(chip::RendezvousInformationFlags(chip::RendezvousInformationFlag::kBLE));
}

void diagnostic_task(void *) {
    const int64_t deadline = esp_timer_get_time() + 10000000;
    esp_err_t attached = card_config.primary ? ESP_ERR_NOT_FOUND : skull::radio::attach_standalone_gap();
    while (attached == ESP_ERR_NOT_FOUND && esp_timer_get_time() < deadline) {
        attached = skull::radio::attach_matter_gap();
        if (attached == ESP_ERR_NOT_FOUND) vTaskDelay(pdMS_TO_TICKS(50));
    }
    if (attached != ESP_OK) {
        ESP_LOGE(tag, "Matter GAP dispatcher readiness failed: %s; no peer scans started", esp_err_to_name(attached));
    } else if (card_config.primary) {
        while (!matter_ble_ready.load() && esp_timer_get_time() < deadline)
            vTaskDelay(pdMS_TO_TICKS(50));
        if (!matter_ble_ready.load())
            ESP_LOGE(tag, "Matter advertising/address readiness timed out; discovery gate FAILED");
    }
    if (attached == ESP_OK && (!card_config.primary || matter_ble_ready.load()) && *card_config.speaker_name) {
        skull::radio::Config config{card_config.speaker_name, card_config.secondary_mac, card_config.primary};
        ESP_ERROR_CHECK(skull::radio::start(config));
    }
    ESP_LOGI("lifecycle", "event=control_ready boot_ms=%lld app_ms=%lld gap_result=%s radio_started=%d",
             static_cast<long long>(esp_timer_get_time() / 1000),
             static_cast<long long>((esp_timer_get_time() - app_entry_us) / 1000),
             esp_err_to_name(attached), attached == ESP_OK && (!card_config.primary || matter_ble_ready.load()) && *card_config.speaker_name);
    ESP_LOGI(tag, "Skull ready. Commands: status, fault-log, fault-saved, fault-test, speaker-name [exact name], asset /audio/<file>.wav, heap-start, heap-stop, tone, trigger, pair /audio/<file>.wav, play /audio/<file>.wav, jaw-test, retry, pairing, reboot, factory-reset CONFIRM. Matter On requests a paired skit.");
    char line[256]{};
    size_t used = 0;
    bool overflowed = false;
    int64_t next_status = 0;
    while (true) {
        skull::show::set_jaw_inhibited(skull::actuators::jaw_state().mode != skull::actuators::JawMode::automatic);
        skull::startup::poll(skull::radio::stream_ready());
        const bool tone_active = tone_frames.load(std::memory_order_relaxed) != 0;
        skull::show::tick(skull::startup::finished(), skull::startup::playing() || tone_active);
        const auto startup_animation = skull::startup::animation();
        const auto show_animation = skull::audio::animation();
        const bool audio_active = skull::radio::stream_ready() &&
            (skull::startup::playing() || tone_active || skull::show::busy() || skull::audio::busy());
        skull::actuators::speaker_connection(skull::radio::speaker_connected());
        skull::actuators::tick(startup_animation.rms ? startup_animation.rms : show_animation.rms,
                              startup_animation.speaking || show_animation.speaking, audio_active);
        lifecycle_poll();
        // This control task owns show/prepare; quiescent includes worker FILE close.
        skull::faultlog::poll(fault_log_idle(), skull::storage::mounted());
        skull::network::poll(fault_log_idle());
        skull::show::set_jaw_inhibited(skull::actuators::jaw_state().mode != skull::actuators::JawMode::automatic);
        char character;
        if (uart_read_bytes(UART_NUM_0, &character, 1, pdMS_TO_TICKS(20)) == 1) {
            if (character == '\r' || character == '\n') {
                line[used] = '\0';
                if (overflowed) ESP_LOGW(tag, "Command discarded: overlong or invalid line");
                else if (!std::strcmp(line, "status")) status();
                else if (!std::strcmp(line, "fault-log")) skull::faultlog::dump();
                else if (!std::strcmp(line, "fault-saved")) {
                    if (fault_log_idle() && skull::storage::mounted()) skull::faultlog::dump_saved();
                    else ESP_LOGW(tag, "Saved fault read refused: playback active or SD unavailable");
                }
                else if (!std::strncmp(line, "mqtt-config ", 12)) {
                    if (fault_log_idle()) {
                        const bool saved=skull::network::configure_mqtt(line+12);
                        ESP_LOGI(tag,"MQTT broker configuration %s; credentials redacted; reboot to apply",saved?"saved":"rejected");
                    } else ESP_LOGW(tag,"MQTT configuration refused while playback active");
                }
                else if (!std::strcmp(line, "fault-test")) {
                    if (fault_log_idle()) skull::faultlog::test_fault();
                    else ESP_LOGW(tag, "Fault test refused while show/audio/startup/tone active");
                }
                else if (!std::strcmp(line, "speaker-name") || !std::strncmp(line, "speaker-name ", 13)) {
                    // This task also owns show preparation: no audio file can
                    // open during this synchronous, idle-only transaction.
                    if (skull::show::busy() || !skull::audio::quiescent() ||
                        skull::startup::playing() || tone_frames.load() != 0) {
                        ESP_LOGW(tag, "Speaker config refused while show/audio/startup/tone or SD file active");
                    } else if (line[12] == ' ') {
                        const esp_err_t saved = skull::storage::set_speaker_name(line + 13);
                        if (saved == ESP_OK)
                            ESP_LOGI(tag, "Speaker name saved and verified on SD: '%s'; reboot to apply (current boot '%s')", line + 13, card_config.speaker_name);
                        else ESP_LOGE(tag, "Speaker name update failed: %s; inspect config and retained transaction files before retry", esp_err_to_name(saved));
                    } else {
                        skull::storage::Config saved;
                        const esp_err_t read = skull::storage::mount_and_read_config(saved);
                        if (read == ESP_OK) ESP_LOGI(tag, "SD speaker name: '%s'; current boot '%s'", saved.speaker_name, card_config.speaker_name);
                        else ESP_LOGE(tag, "Speaker config read failed: %s", esp_err_to_name(read));
                    }
                }
                else if (!std::strncmp(line, "asset ", 6) && !skull::show::busy()) inspect_asset(line + 6);
                else if (!std::strcmp(line, "heap-start") && !heap_window) {
                    heap_window = heap_caps_monitor_local_minimum_free_size_start() == ESP_OK;
                    ESP_LOGI(tag, "Local heap window %s", heap_window ? "started" : "failed");
                    status();
                }
                else if (!std::strcmp(line, "heap-stop") && heap_window) {
                    status(); // Record window minimum before restoring boot history.
                    ESP_LOGI(tag, "Local heap window stop: %s", esp_err_to_name(heap_caps_monitor_local_minimum_free_size_stop()));
                    heap_window = false;
                }
                else if (!std::strcmp(line, "tone")) ESP_LOGI(tag, "Serial tone %s", request_tone() ? "accepted" : "ignored");
                else if (!std::strcmp(line, "trigger")) ESP_LOGI(tag, "Serial paired trigger %s", skull::show::trigger() ? "accepted" : "ignored");
                else if (!std::strncmp(line, "pair ", 5)) ESP_LOGI(tag, "Named paired diagnostic %s", (tone_frames.load() == 0 && skull::show::paired(line + 5)) ? "accepted" : "ignored");
                else if (!std::strncmp(line, "play ", 5)) ESP_LOGI(tag, "Local diagnostic play %s", (tone_frames.load() == 0 && skull::show::local(line + 5)) ? "accepted" : "ignored");
                else if (!std::strcmp(line, "jaw-test") && !skull::startup::busy() && !skull::show::busy() && !skull::audio::busy()) skull::actuators::test();
                else if (!std::strcmp(line, "retry") && tone_frames.load() == 0 && !(skull::startup::busy() && skull::radio::stream_ready()) && ((!skull::show::busy() && !skull::audio::busy()) ||
                         (skull::audio::stats().cancel_waiting && !skull::radio::stream_ready()))) skull::radio::retry_connections();
                else if (!std::strcmp(line, "pairing") && card_config.primary) chip::DeviceLayer::SystemLayer().ScheduleLambda([]() { pairing(); });
                else if (!std::strcmp(line, "reboot")) {
                    // This task also schedules shows/prepare, so an accepted
                    // reboot cannot race a newly launched SD read. Waiting for
                    // initial speaker discovery is safe: startup PCM was loaded
                    // and its FILE closed before this task was created.
                    if (skull::show::busy() || !skull::audio::quiescent() ||
                        skull::startup::playing() || tone_frames.load() != 0)
                        ESP_LOGW(tag, "Reboot refused while show/audio/startup/tone or SD file active; retry when idle");
                    else esp_restart();
                }
                else if (!std::strcmp(line, "factory-reset CONFIRM") && card_config.primary) {
                    chip::DeviceLayer::SystemLayer().ScheduleLambda([]() { esp_matter::factory_reset(); });
                }
                else if (used) ESP_LOGW(tag, "Unknown command");
                used = 0;
                overflowed = false;
            } else if (!overflowed) {
                const auto value = static_cast<unsigned char>(character);
                if (value < 32 || value == 127) { used = 0; overflowed = true; }
                else if (used < sizeof(line) - 1) line[used++] = character;
                else { used = 0; overflowed = true; }
            }
        }
        if (esp_timer_get_time() >= next_status) {
            status();
            next_status = esp_timer_get_time() + 10000000;
        }
    }
}
}

extern "C" void app_main() {
    app_entry_us = esp_timer_get_time();
    ESP_LOGI(tag, "TwoSkulls shared WROVER firmware (onboard SD, A2DP, BLE, Matter)");
    ESP_ERROR_CHECK(skull::actuators::init());
    ESP_ERROR_CHECK(nvs_flash_init()); // Never erase fabric/NVS automatically.
    skull::faultlog::init();
    ESP_LOGI("lifecycle", "event=boot boot_ms=%lld app_entry_ms=%lld reset_reason=%d",
             static_cast<long long>(esp_timer_get_time() / 1000),
             static_cast<long long>(app_entry_us / 1000), static_cast<int>(esp_reset_reason()));
    // Install once before SD setup, so failed boot still has diagnostics.
    ESP_ERROR_CHECK(uart_driver_install(UART_NUM_0, 1024, 0, 0, nullptr, 0));
    ESP_LOGI(tag, "PSRAM initialized=%d size=%u", esp_psram_is_initialized(), static_cast<unsigned>(esp_psram_get_size()));
    unsigned storage_attempt = 1;
    esp_err_t sd = boot_storage_attempt(storage_attempt);
    while (sd != ESP_OK) {
        // Boot has no audio worker yet. Retain faults to flash only here;
        // existing boot recovery owns card remounts, independent of the logger.
        skull::faultlog::poll(true, false);
        wait_for_boot_storage_retry(sd, storage_attempt);
        // No audio file or producer exists yet; remount permits a repaired or
        // reinserted card to recover without stale host/card state.
        const esp_err_t unmount = skull::storage::unmount_for_retry();
        if (unmount != ESP_OK) ESP_LOGW(tag, "Retry unmount: %s", esp_err_to_name(unmount));
        if (storage_attempt != 0xffffffffu) ++storage_attempt;
        sd = boot_storage_attempt(storage_attempt);
    }
    // Do not carry a partial boot-only command into the later runtime console.
    ESP_ERROR_CHECK(uart_flush_input(UART_NUM_0));
    tag = card_config.primary ? "anthony" : "jeff";
    // Eyes can diagnose SD recovery before this point, but no jaw pulse may
    // use an obsolete closed endpoint before the per-skull card is read.
    ESP_ERROR_CHECK(skull::actuators::configure_jaw(card_config.jaw_closed_us, card_config.jaw_open_us) ? ESP_OK : ESP_ERR_INVALID_ARG);
    ESP_LOGI(tag, "Configured role=%s", card_config.primary ? "primary" : "secondary");
    ESP_LOGI("lifecycle", "event=config_ready boot_ms=%lld attempts=%u role=%s",
             static_cast<long long>(esp_timer_get_time() / 1000), storage_attempt, card_config.primary ? "primary" : "secondary");
    const unsigned blinks = card_config.primary ? 4 : 2;
    skull::actuators::diagnostic(blinks);
    ESP_LOGI(tag, "Boot eye diagnostic: %u flashes", blinks);
    // Finish both the role flashes and gentle check before lengthy radio setup.
    const unsigned role_ticks = (skull::actuators::diagnostic_duration_ms(blinks, false) + 19) / 20;
    for (unsigned i = 0; i <= std::max(60u, role_ticks); ++i) {
        skull::actuators::tick(0, false);
        vTaskDelay(pdMS_TO_TICKS(20));
    }
    if (sd == ESP_OK) {
        skull::startup::load(card_config.primary, card_config.volume_percent);
        assets = static_cast<skull::catalog::Catalog *>(heap_caps_malloc(sizeof(skull::catalog::Catalog), MALLOC_CAP_SPIRAM | MALLOC_CAP_8BIT));
        if (assets) new (assets) skull::catalog::Catalog;
        if (!assets || !skull::catalog::scan(*assets, "/sdcard/audio")) {
            ESP_LOGE(tag, "Audio catalog unavailable");
            if (assets) heap_caps_free(assets);
            assets = nullptr;
        }
        if (assets && !skull::audio::init(card_config.volume_percent, card_config.primary)) {
            ESP_LOGE(tag, "PCM producer initialization failed; skit control disabled");
            heap_caps_free(assets); assets = nullptr;
        }
    }
    skull::show::init(assets, card_config.primary);
    const int64_t radio_started_us = esp_timer_get_time();
    const esp_err_t radio_init = skull::radio::init(provide_pcm);
    ESP_LOGI("lifecycle", "event=radio_init boot_ms=%lld duration_ms=%lld result=%s",
             static_cast<long long>(esp_timer_get_time() / 1000),
             static_cast<long long>((esp_timer_get_time() - radio_started_us) / 1000), esp_err_to_name(radio_init));
    ESP_ERROR_CHECK(radio_init);
    if (card_config.primary) {
        node::config_t node_config{};
        std::strcpy(node_config.root_node.basic_information.node_label, "Anthony prototype");
        node_t *root = node::create(&node_config, attribute_update, identify);
        ESP_ERROR_CHECK(root ? ESP_OK : ESP_FAIL);
        endpoint::on_off_plug_in_unit::config_t trigger_config{};
        trigger_config.on_off.on_off = false;
        endpoint_t *trigger = endpoint::on_off_plug_in_unit::create(root, &trigger_config, ENDPOINT_FLAG_NONE, nullptr);
        ESP_ERROR_CHECK(trigger ? ESP_OK : ESP_FAIL);
        trigger_endpoint = endpoint::get_id(trigger);
        ESP_ERROR_CHECK(esp_matter::start(matter_event));
        chip::DeviceLayer::SystemLayer().ScheduleLambda([]() {
            reset_momentary(nullptr, nullptr); // Hydrated On never starts a show.
            // Commissioned boot does not advertise or set a random address until
            // a future explicit commissioning window; the peer uses a public address.
            if (chip::Server::GetInstance().GetFabricTable().FabricCount() != 0)
                matter_ble_ready.store(true);
            else pairing();
        });
    } else ESP_ERROR_CHECK(skull::secondary::init());
    skull::network::init(card_config.primary, assets);
    ESP_ERROR_CHECK(xTaskCreate(diagnostic_task, "skull_diag", 6144, nullptr, 4, nullptr) == pdPASS ? ESP_OK : ESP_ERR_NO_MEM);
}
