copperdogma/TwoSkulls/(commit log)

2024-08-29 Checkpoint: bad syncing and crashing
    [TwoSkulls.ino, audio_player.h]
2024-08-29 Checkpoint: skit part support sort of working not crashing
    [TwoSkulls.ino, audio_player.h]
2024-08-29 Checkpoint: working with skits but crashes
    [TwoSkulls.ino, audio_player.h]
2024-08-29 Checkpoint 1: refactor(Two_Skulls): extract LED control to LightController
    - Move LED-related functions to new LightController class
    - Simplify setup() by using LightController methods
    - Adjust blink patterns for primary/secondary roles
    - Add servo initialization animation in setup()
2024-08-29 Checkpoint 3: refactor(audio): improve servo control and cleanup code
    Introduce ServoController class, remove redundant code, update servo
    initialization and position mapping, and clean up TODOs and comments.
2024-08-29 Checkpoint 4: refactor(servo): move initialization to ServoController
    Move servo initialization and animation from setup() to ServoController.
    Improve code organization and encapsulation of servo-related functionality.
2024-08-29 Checkpoint 5: refactor: remove unused imports and variables
    Remove Servo library import and unused connection/button variables
2024-08-29 Checkpoint 6: refactor(audio): integrate ServoController with AudioPlayer
    Moves servo control logic to ServoController, updates AudioPlayer
    to use it via dependency injection, and adjusts related code.
2024-08-29 Checkpoint 7: refactor(servo): move servo control to ServoController
    Remove servo-related methods from AudioPlayer, use ServoController
    directly in Two_Skulls.ino for improved separation of concerns
2024-08-29 Checkpoint 8: refactor(audio): remove unused servo methods and includes
    Remove deprecated servo-related methods and Servo.h include from AudioPlayer
2024-08-29 Checkpoint 11: docs(issues): add note about flaky Bluetooth reconnection
    [TwoSkulls.ino]
2024-08-29 Checkpoint 12: refactor(SD): Improve SD card initialization logging
    Enhance error handling and logging for SD card initialization process. Add detailed status messages for required files and skit processing. Simplify skit file parsing logic and provide more informative output.
    [TwoSkulls.ino]
2024-08-29 Checkpoint 15: refactor(setup): Optimize initialization and memory usage
    Remove unused vectors, reorganize sensor initialization, add debug output
2024-08-29 Checkpoint 16: refactor(audio): Improve audio playback and file handling
    Enhance AudioPlayer with end-of-file detection, skit updates, and more robust file management. Add new issues to track future improvements.
    [TwoSkulls.ino, audio_player.h]
2024-08-29 Checkpoint 17: refactor(audio): Improve servo control and audio processing
    Simplify ServoController, introduce AudioState struct, move audio
    processing to separate function, and update SkullAudioAnimator
2024-08-29 Checkpoint 18: refactor: improve memory management and thread safety
    Implement RAII, use atomic variables for thread safety, and add
    cleanup function. Fix minor issues in audio processing logic.
    [TwoSkulls.ino]
2024-09-02 Checkpoint 0:
    Debugging crash while playing audio
    - re-added servo init (closed/open/closed)
    - added debug code
    [TwoSkulls.ino]
2024-09-03 More audio player debugging
    - still crashing
    [TwoSkulls.ino, audio_player.h]
2024-09-04 Audio deugging
    - no longer crashing (usually) but stopping audio playback partway through large files
    - however it's now complaining with this newly added debug line: _provideAudioFrames: Failed to read from file!
    - so maybe it wasn't the audio code but the SD/reader code
    [TwoSkulls.ino, audio_player.h]
2024-09-04 Audio working
    GOOD LORD.. I've been trying to fix this for days and days and it turned out it was a SHIELDING issue! Chalk it up to my absolute inexperience with hardware. Turns out the servo is electrically noisy. When I unplugged it, the init and "Skit - names" audio both played perfectly ten times in row. When the servo was plugged in the best I ever saw was playing the init and 30% of "Skit - names" before crashing.
    So now I'm going to try shielding the SD card and its wires.
2024-09-08 refactor: improve Bluetooth and config management
    Update README, add config manager, enhance Bluetooth handling,
    improve error reporting, and optimize memory usage.
    [TwoSkulls.ino, config_manager.cpp, config_manager.h]
2024-09-08 More config.txt
    - New setting: speaker_volume
    - Now uses actual config.txt ultrasonic_trigger_distance setting
2024-09-08 config.txt/role now source of skull's role instead of ultrasonic sensor presence
2024-09-09 refactor(audio): improve playback and Bluetooth handling
    Streamline AudioPlayer, enhance SkullAudioAnimator, optimize buffer
    management, and improve Bluetooth integration for smoother playback.
    ** NOTE: this broke skit processing for now
    [TwoSkulls.ino, audio_player.h]
2024-09-10 Fixed audio queuring issue
    - Now plays every queued file in order instead of only the last queued file.
    [TwoSkulls.ino, audio_player.h]
2024-09-10 Fixed issue where it wasn't running the loop
    - note: WAY too much logging in this one; will be removed
    [TwoSkulls.ino]
2024-09-11 Now animates the eyes: bright when current skull is talking, otherwise dim
2024-09-11 Cleaned up LED control code
2024-09-11 Working LED animation skit sync
    - whole new system to track skits, current position within them, how that relates to lines within the skit, and which skull should play what
    - makes LED eyes bright when saying its line and dim when the other skull's lines are spoken
    - VERY messy and way too much dumped to the log, but working!
    [TwoSkulls.ino, audio_player.h, sd_card_manager.cpp]
2024-09-12 SkullAudioAnimator/AudioPlayer cleanup
    - checkpoint of working code
    - lots to still clean up, remove, and way too much debug logging
    [TwoSkulls.ino, audio_player.h]
2024-09-12 Greatly simplified audio_player
    - Deep refactoring. Originally had 3 triggers (update(), alway running audioPlayerTask(), and bluetooth-driven provideAudioFrames(). Now all functionality driven by adding new files (playNext()) and provideAudioFrames() polling.
    - Didn't fix issue of not properly timing the non-skit file so the eyes don't turn on during playback of that,
    - New issue: basically the timing system is borked and it thinks playback starts as soon as you init the audio_player instead of when bluetooth actually starts playing each file. Working on that next.
    [audio_player.h]
2024-09-12 Audio player buffer/timing refactor
    - Now only refills the buffer if it's at the end of a file and the buffer is completely empty.
    - This lets us know when we're starting a new file so we can accurately reset the elapsed time playing the current file.
    [audio_player.h]
2024-09-13 Skit line muting working
    - Each skull now only speaks its own lines from a skit
    - Still correctly speaks non-skit files
    [audio_player.h]
2024-09-13 Basic P2P wifi support added
    - NOT workking properly
    - added primary_mac_address and primary_mac_address to config.txt and added support code to read/parse
    [TwoSkulls.ino, config_manager.cpp, config_manager.h, sd_card_manager.h]
2024-09-14 Comms improvements
    - streamlined connection, timeout, keepalives, and acks
    - added voltage debugging statements in loop()
2024-09-15 Revert "Audio: now fades at start/end of audio to massively reduce clicking"
    This reverts commit a8db621ef4cd0af59c4f2effee616b3893060e44.
    [audio_player.h]
2024-09-15 Reapply "Audio: now fades at start/end of audio to massively reduce clicking"
    This reverts commit e2e08d59d54d4cab9676d24850f8fcdae9591e6a.
    [audio_player.h]
2024-09-15 Revert "Reapply "Audio: now fades at start/end of audio to massively reduce clicking""
    This reverts commit d7a9c27eacdfa20a64e2a9cb653677a3cff3a5bb.
    [audio_player.h]
2024-09-15 Audio: now skips header to avoid clicks
    - turns out some of the start/end noise was ACTUALLY IN THE AUDIO FILE;) so I edited those as well
    - added delay playing Polo so they don't talk over each other
    [TwoSkulls.ino]
2024-09-15 OOPS: Audio: last commit was broken
    [TwoSkulls.ino]
2024-09-16 Comms: simplified + turn-taking
    - simplified connection; now there's just connect/ack and play/ack, and if it EVER connects it marks it as connected
    - pretty broken, poor connection, commented out code
    - next up: pause comms until bluetooth connected
    [TwoSkulls.ino]
2024-09-16 Refactoring audio
    - moving toward decoupling audio_player and skull_audio_animator
    - I made a mistake putting SAA in charge of AP. The INO should control AP, and AP should use callbacks to declare it's playing state. Same with skull_communicator. If it wants a file played it should raise a callback and the INO should coordinate. That's next.
    [TwoSkulls.ino]
2024-09-17 Refactoring
    - partway through refactoring so make INO more of a coordinator for all, using callbacks to communicate
    - this checkin breaks skull_audio_animator which no longer does anything (yet)
    [TwoSkulls.ino, audio_player.h]
2024-09-17 Refactoring audioplayer
    - removed AP passthroughs in SkullAudioAnimator
    - started adding callbacks for important events in AP (not working yet)
    [TwoSkulls.ino, audio_player.h]
2024-09-17 Refactoring AudioPlayer
    - Introduced far better tracking of currently playing file
    - audio plays, but callbacks not correct yet
    [audio_player.h]
2024-09-18 Refactoring AudioPlayer
    - 16bits at start of each audio buffer frame identifying frame as max(int16) = last frame of file, int>0 = fileIndex (in array of all files played), or 0 = same as last frame
2024-09-18 Refactoring AudioPlayer
    - more compact
    - more broken in writing fileIndex properly;)
    [TwoSkulls.ino, audio_player.h]
2024-09-18 Refactoring AudioPlayer
    - FINALLY properly stamps audio frames with start of file, same file, or end of file markers
    - provideAudioFrames() isn't interpreting them correctly right now, though
2024-09-18 Refactoring AudioPlayer: sorted out fileIndices
    - no longer conflates them with fileIndex
    - now has two: currentBufferFileIndex and currentPlaybackFileIndex
    [audio_player.h]
2024-09-19 Refactoring AudioPlayer
    - better handling of fileIndex in provideAudioFrames()
    - still broken, though, and sending wrong fileIndex via callback
    [TwoSkulls.ino]
2024-09-19 Updated Frame def docs
2024-09-19 Refactoring AudioPlayer
    - new tack: eliminate fileIndex from the audio buffer data and track the buffer position of the end of file separately (that's really all we need to know for file start/end)
    - this step is just removing fileIndex from the buffer (baby steps!)
2024-09-19 Refactoring AudioPlayer
    - now calls the playbackStartCallback and playbackEndCallback
    - ISSUE: but not at the right times;)
    - audio still works perfectly
    [TwoSkulls.ino]
2024-09-19 Refactoring AudioPlayer
    - Finally working!
    - Queues files, reads from files, fills circular buffer, marks end-of-file in file queue, and streaming checks current read position vs that end-of-file in the file queue and raises file start/end callbacks.
    - next: cleanup
2024-09-20 Added RadioManager
    - added new RadioManager to coordinate radio access between AudioPlayer and SkullCommunication, and removed some of the earlier attempt to do the same. This is NOT yet properly integrated.
    - added .cursorrules, which instruct CursorAI on how to behave.
    - fixed constant defs in audio_player
    - moved many refs from raw pointers to references for safety/fewer checks
    - next: properly integrate RadioManger in AudioPlayer and SkullCommunication
    [TwoSkulls.ino, audio_player.h]
2024-09-20 RadioManager: rebuilt, not working
    - Greatly simplified the thing. Any function wanting access to the radio now just requests and says how long it wants it. If not busy it's granted. It doesn't have to explicitly release it as it's expected to auto-time out. Everything runs on a fast loop so they just keep renewing their lock until they no longer need it.
    [audio_player.h]
2024-09-21 RadioManager: 100% working
    - proper integration with audio_player so it doesn't request access nonstop
    [TwoSkulls.ino]
2024-09-21 RadioManager more work (NOT WORKING)
    - now waits until Bluetooth is initialized and speaker connected before attempting to connect to the other skull (if it can't play audio there's no point)
    - THIS DOESN'T WORK. Well, it works as well as any code has, but I think the wifi and A2DP can NOT be used at the same time. The A2DP just takes priority and the wifi is left severely compromised. going to try simultaneous A2DP/BLE
    [TwoSkulls.ino, audio_player.h]
2024-09-22 BLE experimentation
    - BLE proof of concept, running BLE characteristic reading/writing WHILE A2DP audio is playing
    - just HACKED into the bluetooth_audio for now to see if it will work
    - NOTE: broke skull communication completely; disabled RadioManager (never coming back) and SkullCommunication (we'll see)
    [TwoSkulls.ino]
2024-09-22 BluetoothController: basics complete
    - now has full server and client functionality
    - server doesn't have proper characteristics set up yet, but it has test ones and they work
    - client doesn't attempt to connect to server yet
    [TwoSkulls.ino]
2024-09-24 BluetoothController: WORKING! Proper client->server comms
    - client can now successfully connect to the server
    - client can write to the server's characteristic successfully (even though the log says it was unsuccessful on the client side, the server successfully receives and prints the set value)
    - there were a LOT of experimental changes to get this working and I'm not 100% what got it working in the end, so a ton of clean up needs to be done
    - added prompts folder with add-comments.md and used it to comment the bluetooth files (trick from Cursor.ai) which I THINK helped get this issue solved finally
2024-09-26 SkullAudioAnimator revival
    - added back in
    - does nothing yet
    - removed dependencies on radioManager (never did use it) and audioPlayer (need a bunch of work to restore this functionality
    - next: feed audio frames into SAA from INO
2024-09-26 SkullAudioAnimator: broken progress
    - not working at all, not even tested
    - moved servo constants into config_manaager
    - in the middle of getting it ready to intake audio frames from the INO
    [TwoSkulls.ino, config_manager.cpp, config_manager.h]
2024-09-26 SkullAudioAnimator: initial working version
    - the INO has a callback where it gets audio frames form audioPlayer, which it feeds into skull_audio_animator.processAudioFrames()
    - the eyes now light up when playing audio
    - the jaw moves when speaking, somewhat according to the audio levels
    - skit processing is wrong; it's not identifying when it should be speaking or not, obvious because the eyes stay on the entire time
    [TwoSkulls.ino]
2024-09-26 SkullAudioAnimator: now mutes audio during skits
    - added SAA callback, triggered when it's playing a skit but not currently speaking
    - ISSUE: it mutes, triggered by skit lines, but they're way off because of an underlying timing issue that needs to be fixed (next)
    [TwoSkulls.ino]
2024-09-26 SkullAudioAnimator
    - WORKING! properly animates eyes and jaw according to audio playing and, if it's playing a skit, who is supposed to be talking
    - ISSUE: it's not getting the boundaries of skit lines quite right yet
    [TwoSkulls.ino, audio_player.h]
2024-09-26 Fixed eye brightness
    - now goes to full LED brightness and back to dim properly instead of dim and more dim
    - NOTE: this is a terrible hack. I couldn't get PWM working to drive the LEDs to full brightness, so I'm just overriding a max call to set the pin to HIGH
2024-09-26 SkullAudioAnimator: 100% working!
    - Had to dynamically trim 200ms off the end of the skit. I think because we never detect a new file starting, just the old file ending, but that means we're "starting" it before it actually starts playing because that's just the start of buffering.
    - ISSUE: spits out endless "SkullAudioAnimator: currentFile is empty; setting m_isCurrentlySpeaking to false" at the end but no other apparent negative effect.
2024-09-27 SkullAudioAnimator: complete
    - 100% working
    - ISSUE: SOMETIMES clips the starting 100-200ms off Secondary audio for some reason
    [TwoSkulls.ino]
2024-09-28 Audio rebuilds
    - rebuilt audio timing system on audio_player
    - revised audio timing reactions on skull_audio_animator
    - ISSUE: mis-timing of skit line playback/mute clipping still not resolved, but I think we're in a better place
    [TwoSkulls.ino, audio_player.h]
2024-09-28 AudioPlayer: fixed playback timing
    - Now calculated time played in current file based on bytes read instead of wall clock. This makes up for a lot of playback-related issues that can cause the file to be played at the incorrect rate.
    [audio_player.h]
2024-09-28 Code tweaks
    - Now resets audio counter so it doesn't overflow
    - Restored voltage calculations to main loop() debug
    [TwoSkulls.ino, audio_player.h]
2024-09-28 Ultrasonic Skit Selector + Playing
    - Added new SkitSelector that manages the random selection of skits, weighted by which were played last
    - Now, once fully connected, waits for an ultrasonic trigger, randomly chooses a skit, and coordinates with the other skull to play it
2024-10-04 Bugfix: SkitSelector can no longer choose the same skit twice in a row
    [TwoSkulls.ino]
2024-10-04 Ultrasonic trigger now waits 10 seconds after finishing audio file before playing another
2024-10-05 Fixed timing issue
    - AudioPlayer wasn't always resetting current playback time back to 0 at the start of a new file.
    [TwoSkulls.ino]
2024-10-07 Bugfix: sometimes Primary would play but Secondary wouldn't
    - added verification step where Secondary can reject a "play audio" command, and Primary would understand and not play the file
    [TwoSkulls.ino]
2024-10-07 Fixing: secondary power supply shuts down when inactive
    - added keepalive: jaw moves every 5 seconds to draw enough power to keep battery on
    - NOT WORKING: need more draw, but this is a good checkpoint
    [TwoSkulls.ino]
2024-10-07 Feature: breathing animation when inactive
    - This was originally a keepalive to draw enough battery power to keep the power bank from shutting down, but turns out if I just plug BOTH usbC cables into the same battery pack the esp32 will draw enough to keep the battery active forever. duh.
    - But I ended up really liking this creepy "breathing" animation so now it's a feature!
2024-10-08 Animation tweaks
    - breathing animation can now be interrupted by speech, whereas originally it would try to do both and not do either, really
2024-10-10 Docs + ultrasonic trigger distance fix
    - redid the README docs, updating it to reality
    - fixed the ultrasonic sensor trigger distance, now reading it from the actual config.txt file instead of the hardcoded constant (why did I ever do that??;)
    [TwoSkulls.ino]
2024-10-10 Ultrasonic baseline
    - now takes a baseline ultrasound reading just in case a static object is within its max distance, otherwise it would trigger over and over on that static object, which now gets ignored
2024-10-14 Added SD card contents to repo
    [config_primary.txt, config_secondary.txt]
2024-10-16 Updated docs, reverted debugging volume divisor
    [TwoSkulls.ino]
2024-10-19 Bugfix: now waits 10 seconds before playing another file
    [TwoSkulls.ino]
2024-10-26 Bugfix: ultrasonic sensor no longer continuously triggers
    [TwoSkulls.ino]
2024-10-30 Ultrasonic tweaks
    - changed SD card to use 1000 distance for detection; seeing as it establishes a baseline it should be fine
    - now blinks eyes on detection to help untethered debugging
    - now includes the ultrasonic tolerance again
    [config_primary.txt]
2024-11-10 Added servo pinout
2025-07-24 Replace ultrasonic sensor with ESP32-C3 Matter controller GPIO trigger
    - Remove all ultrasonic sensor code and dependencies (HCSR04 library)
    - Add GPIO trigger functionality using GPIO 2 for Matter controller
    - Update config files to remove ultrasonic_trigger_distance settings
    - Update README.md to reflect Matter controller instead of ultrasonic sensor
    - Maintain same trigger behavior: primary skull only, same connection checks, same cooldown logic
    - GPIO trigger works exactly like ultrasonic sensor but triggered by Matter controller HIGH pulse
    [config_primary.txt, config_secondary.txt]
2025-08-25 Servo now initializes before SD card + matter trigger pin moved from GPIO 2->1
2026-10-16 Add perfboard design drafts and assembly guidance
2026-11-02 Retain startup and wireless context in SD fault reports
2026-11-03 Add Home Assistant prop controls and per-skull SD jaw calibration
    Expose diagnostics, skit selection/playback and bounded SD report retrieval through MQTT discovery and a native Home Assistant dashboard. Add speaker-disconnection eye warnings and exclusive jaw tuning with verified per-card endpoint saves, conservative motion limits and fault-safe output disabling.
    Record the Mac Mini hub migration and reusable AI integration guide. Validate portable suites with ASan/UBSan, native ESP-IDF build and size, independent code review, and Jeff owner-confirmed calibration persistence across reboot.
